pamelaleitecontii/desafio_epta/hardware/datalogger/datalogger.kicad_pcb

## KiCad design hardware/datalogger/datalogger.kicad_pcb (2026-10-24)

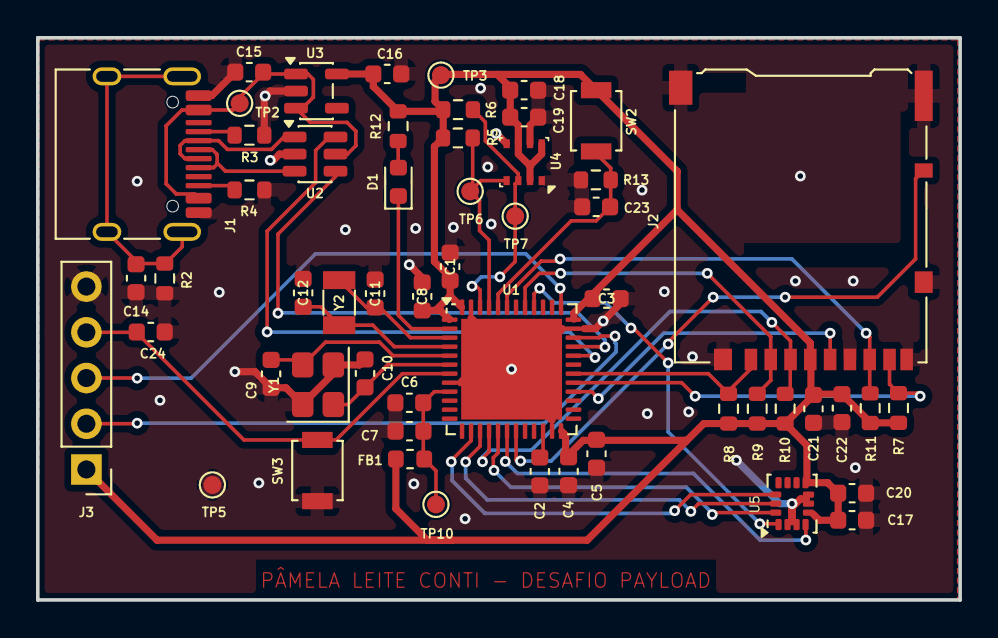
[picture p1: board datalogger.kicad_pcb from above]

Board: 2 copper layers, 51.2 x 31.2 mm, 55 parts (0 on the bottom side), 36 nets.

Parts:
C1, C3, C4, C7, C8, C17, C18, C19, C20, C21, C23, C24: 100nF; C_0603_1608Metric
C2, C5: 4.7µF; C_0603_1608Metric
C6, C15, C16: 1µF; C_0603_1608Metric
C9, C10: 10pF; C_0603_1608Metric
C11, C12: 4.7pF; C_0603_1608Metric
C14: 4.7nF; C_0603_1608Metric
C22: 10µF; C_0603_1608Metric
D1: LED_Small; LED_0603_1608Metric
FB1: 600R@100MHz; L_0603_1608Metric
J1: USB_C_Receptacle_USB2.0_16P; USB_C_Receptacle_HRO_TYPE-C-31-M-12
J2: Micro_SD_Card_Det_Hirose_DM3AT; microSD_HC_Hirose_DM3AT-SF-PEJM5
J3: Conn_01x05_Pin; PinHeader_1x05_P2.54mm_Vertical
R2: 1M; R_0603_1608Metric
R3, R4: 5.1k; R_0603_1608Metric
R5, R6: 4.7k; R_0603_1608Metric
R7, R8, R9, R10, R11, R13: 10k; R_0603_1608Metric
R12: 1k; R_0603_1608Metric
SW2, SW3: SW_Push; SW_SPST_B3U-1000P
TP2, TP3, TP5, TP6, TP7, TP10: TestPoint; TestPoint_Pad_D1.0mm
U1: STM32F411CEUx; QFN-48-1EP_7x7mm_P0.5mm_EP5.6x5.6mm
U2: USBLC6-2SC6; SOT-23-6
U3: AP2112K-3.3; SOT-23-5
U4: BME280; Bosch_LGA-8_2.5x2.5mm_P0.65mm_ClockwisePinNumbering
U5: LSM6DSO; LGA-14_3x2.5mm_P0.5mm_LayoutBorder3x4y
Y1: 25MHz; Crystal_SMD_3225-4Pin_3.2x2.5mm
Y2: 32.768kHz; Crystal_SMD_3215-2Pin_3.2x1.5mm

Connections:
+3V3: C1.1, C3.1, C4.1, C5.1, C8.1, C16.1, C17.2, C18.2, C19.1, C20.2, C21.1, C22.1, FB1.1, J2.4 (VDD), J3.1, R5.2, R6.2, R7.1, R8.1, R9.1, R10.1, R11.1, R12.1, SW2.2, TP3.1 (1_1), U1.1 (VBAT), U1.24 (VDD), U1.36 (VDD), U1.48 (VDD), U3.5 (VOUT), U4.2 (CSB), U4.6 (VDDIO), U4.8 (VDD), U5.5 (VDDIO), U5.8 (VDD)
/Clock_HSE: C9.2, U1.5 (PH0), Y1.3
/Clock_LSE: C11.2, U1.3 (PC14), Y2.2
/I2C1_SCL: R5.1, TP6.1 (1_1), U1.45 (PB8), U4.4 (SCK)
/I2C1_SDA: R6.1, TP7.1 (1_1), U1.46 (PB9), U4.3 (SDI)
/IMU_CS: U1.14 (PA4), U5.12 (CS)
/IMU_INT1: U1.18 (PB0), U5.4 (INT1)
/LED_STATUS: D1.1 (K), U1.2 (PC13)
/SDIO_CK: J2.5 (CLK), U1.28 (PB15)
/SDIO_CMD: J2.3 (CMD), R10.2, U1.16 (PA6)
/SDIO_D0: J2.7 (DAT0), R11.2, U1.43 (PB7)
/SDIO_D1: J2.8 (DAT1), R7.2, U1.29 (PA8)
/SDIO_D2: J2.1 (DAT2), R8.2, U1.30 (PA9)
/SDIO_D3: J2.2 (DAT3/CD), R9.2, U1.41 (PB5)
/SD_DETECT: J2.10 (DET_A), U1.19 (PB1)
/SPI1_MISO: U1.40 (PB4), U5.1 (SDO/SA0)
/SPI1_MOSI: U1.17 (PA7), U5.14 (SDA)
/SPI1_SCK: U1.15 (PA5), U5.13 (SCL)
/SWCLK: J3.3, U1.37 (PA14)
/SWDIO: J3.2, U1.34 (PA13)
/USB_DM: U1.32 (PA11), U2.6 (I/O1)
/USB_DP: U1.33 (PA12), U2.4 (I/O2)
/VBUS: C15.1, J1.A4 (VBUS), J1.A9 (VBUS), J1.B4 (VBUS), J1.B9 (VBUS), TP2.1 (1_1), U2.5 (VBUS), U3.1 (VIN), U3.3 (EN)
/VDDA: C6.1, C7.1, FB1.2, TP10.1 (1_1), U1.9 (VDDA)
BOOT0: C23.1, R13.1, SW2.1, U1.44 (BOOT0)
GND: C1.2, C2.2, C3.2, C4.2, C5.2, C6.2, C7.2, C8.2, C9.1, C10.2, C11.1, C12.2, C14.2, C15.2, C16.2, C17.1, C18.1, C19.2, C20.1, C21.2, C22.2, C23.2, C24.1, J1.A1 (GND), J1.A12 (GND), J1.B1 (GND), J1.B12 (GND), J2.6 (VSS), J2.9 (DET_B), J2.SH (SHIELD), J3.5, R2.2, R3.2, R4.2, R13.2, SW3.2, TP5.1 (1_1), U1.8 (VSSA), U1.23 (VSS), U1.35 (VSS), U1.47 (VSS), U1.49 (VSS), U2.2 (GND), U3.2 (GND), U4.1 (GND), U4.5 (SDO), U4.7 (GND), U5.2 (SDX), U5.3 (SCX), U5.6 (GND), U5.7 (GND), Y1.2 (G), Y1.4 (G)
unnamed: D1.2 (A), R12.2
unnamed: J1.A5 (CC1), R3.1
unnamed: J1.B5 (CC2), R4.1
unnamed: J1.A6 (D+), J1.B6 (D+), U2.3 (I/O2)
unnamed: J1.A7 (D-), J1.B7 (D-), U2.1 (I/O1)
unnamed: C14.1, J1.SH (SHIELD), R2.1
unnamed: C12.1, U1.4 (PC15), Y2.1
unnamed: C10.1, U1.6 (PH1), Y1.1
unnamed: C2.1, U1.22 (VCAP1)
Reset: C24.2, J3.4, SW3.1, U1.7 (NRST)
