pamelaleitecontii/desafio_epta/firmware/firmware.ioc

Mcu.UserName=STM32F411CEUx
PA11.Signal=USB_OTG_FS_DM
PA12.Signal=USB_OTG_FS_DP
PA13.Signal=SYS_JTMS-SWDIO
PA14.Signal=SYS_JTCK-SWCLK
PA4.GPIO_Label=IMU_CS
PA4.Signal=GPIO_Output
PA5.Signal=SPI1_SCK
PA6.Signal=SDIO_CMD
PA7.Signal=SPI1_MOSI
PA8.Signal=SDIO_D1
PA9.Signal=SDIO_D2
PB0.GPIO_Label=IMU_INT1
PB0.Signal=GPXTI0
PB1.GPIO_Label=SD_DETECT
PB1.Signal=GPIO_Input
PB15.Signal=SDIO_CK
PB4.Signal=SPI1_MISO
PB5.Signal=SDIO_D3
PB7.Signal=SDIO_D0
PB8.Signal=I2C1_SCL
PB9.Signal=I2C1_SDA
PC13-ANTI_TAMP.GPIO_Label=LED_STATUS
PC13-ANTI_TAMP.Signal=GPIO_Output
PC14-OSC32_IN.Signal=RCC_OSC32_IN
PC15-OSC32_OUT.Signal=RCC_OSC32_OUT
