pamelaleitecontii/desafio_epta/firmware/Core/Inc/main.h

#define LED_STATUS_Pin GPIO_PIN_13
#define LED_STATUS_GPIO_Port GPIOC
#define IMU_CS_Pin GPIO_PIN_4
#define IMU_CS_GPIO_Port GPIOA
#define IMU_INT1_Pin GPIO_PIN_0
#define IMU_INT1_GPIO_Port GPIOB
#define IMU_INT1_EXTI_IRQn EXTI0_IRQn
#define SD_DETECT_Pin GPIO_PIN_1
#define SD_DETECT_GPIO_Port GPIOB
#define RTC_BKP_ASSINATURA  0x32F2u  /* DR0: RTC já configurado, não zerar a hora */
#define RTC_BKP_AJUSTADO    0x5A5Au  /* DR1: hora acertada pelo RTC.TXT           */
